HuuNgan/AC_Power_Monitoring_System/Hardware/AC Measure Monitor Control Board/v1.pdf

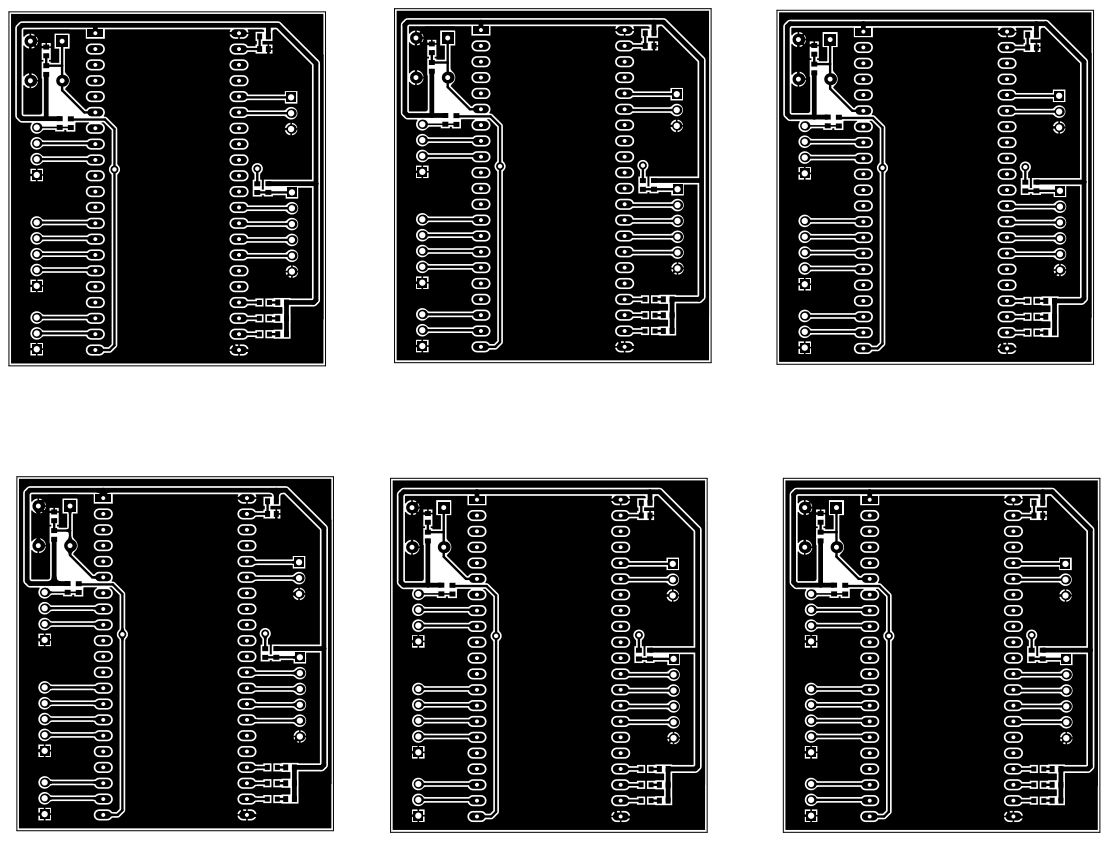
[picture p4: page 1]
