HuuNgan/AC_Power_Monitoring_System/Hardware/Isolation Boost Converter/Isolation_boost.pdf

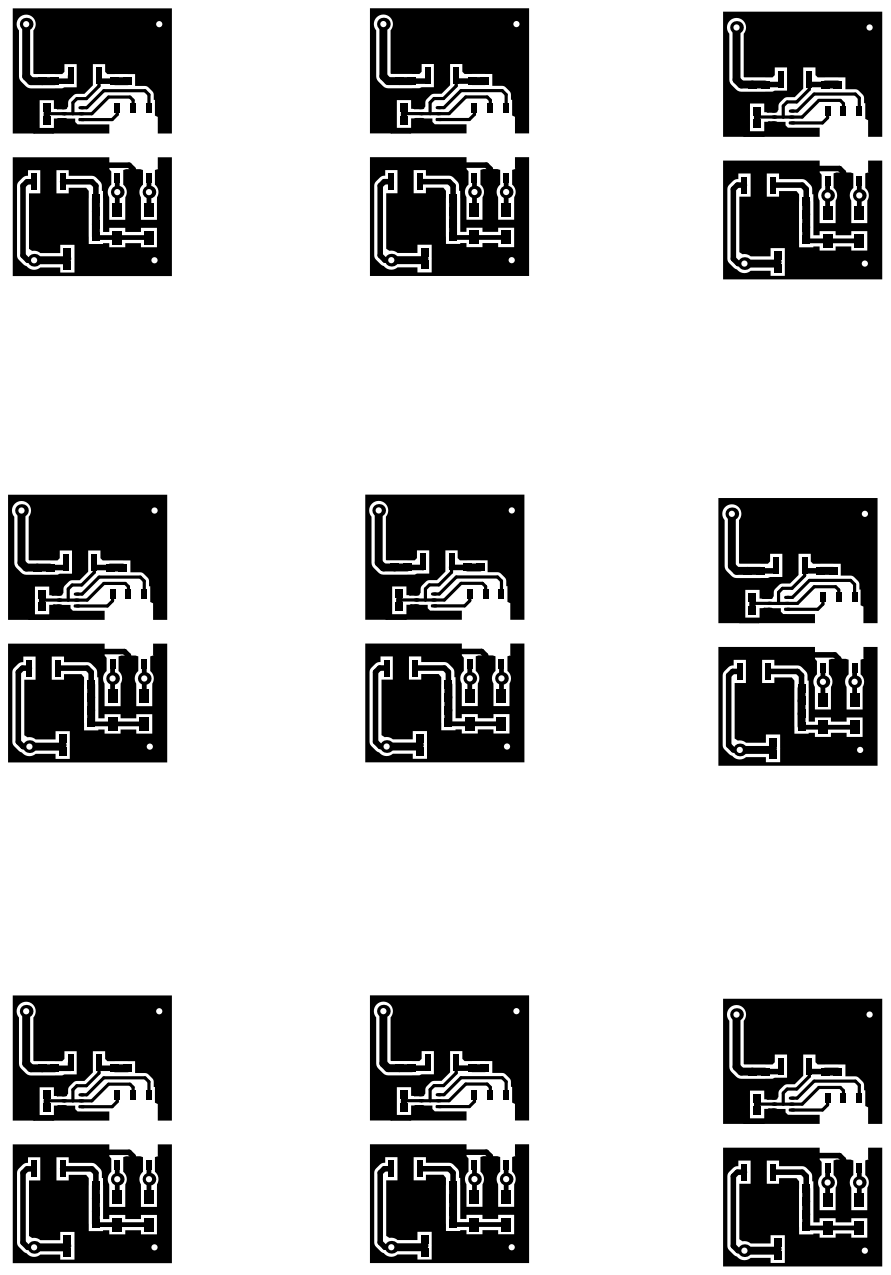
[picture p5: page 1]
