HuuNgan/AC_Power_Monitoring_System/Hardware/AC Measure Monitor Senso Board/Release/2021-03-21/Schematic.pdf

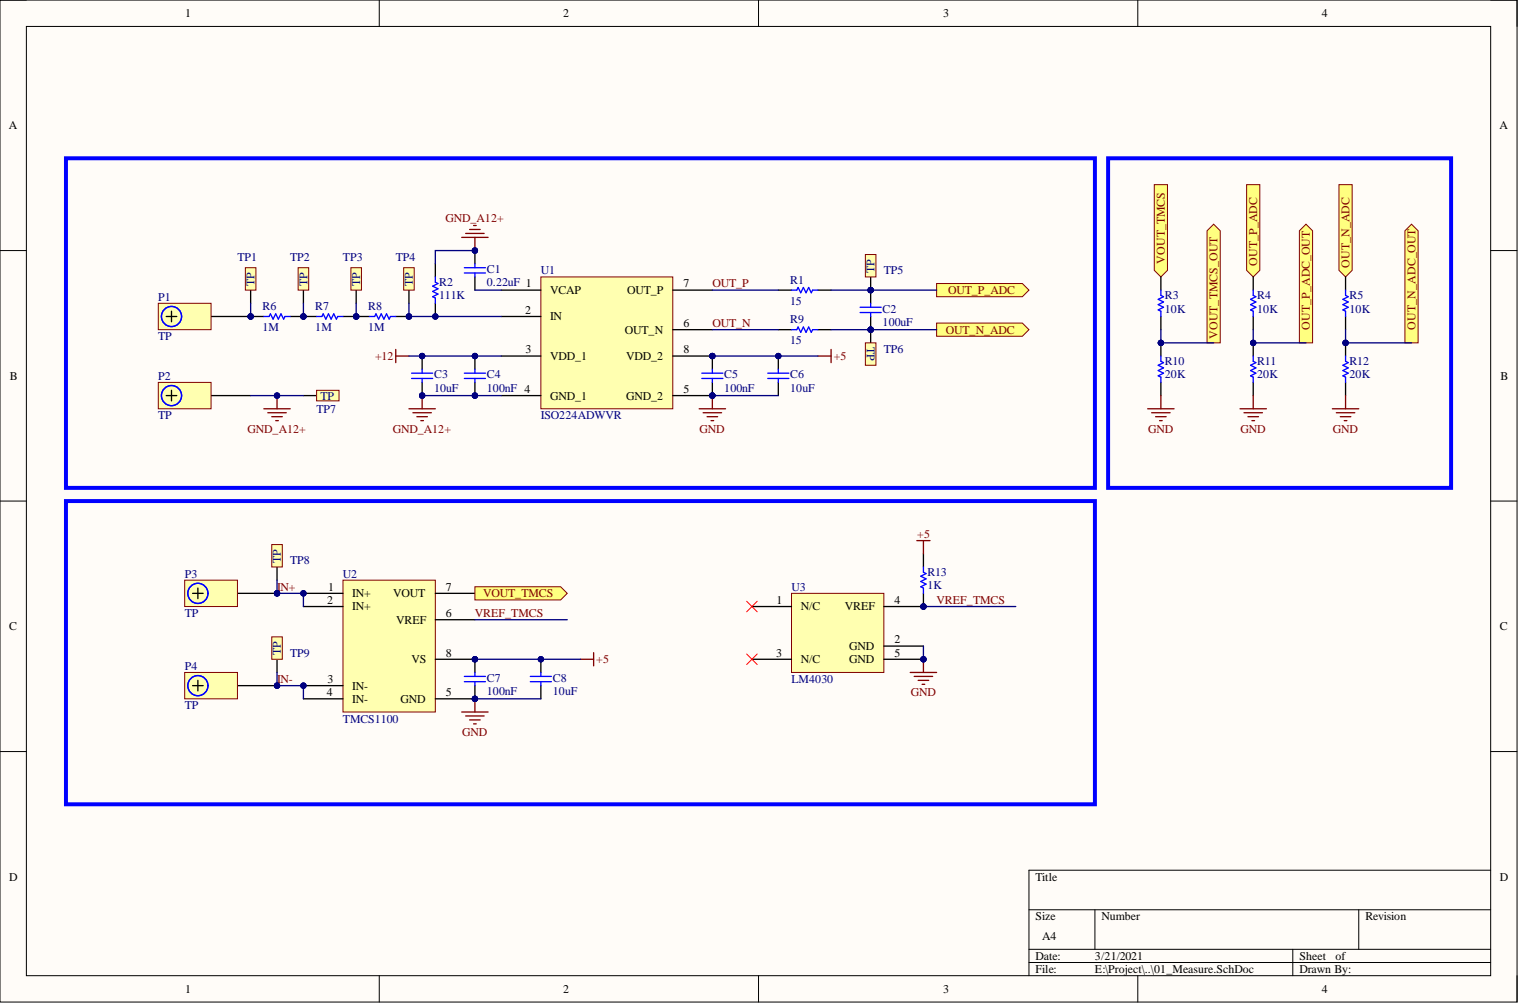
[picture p6: page 1]

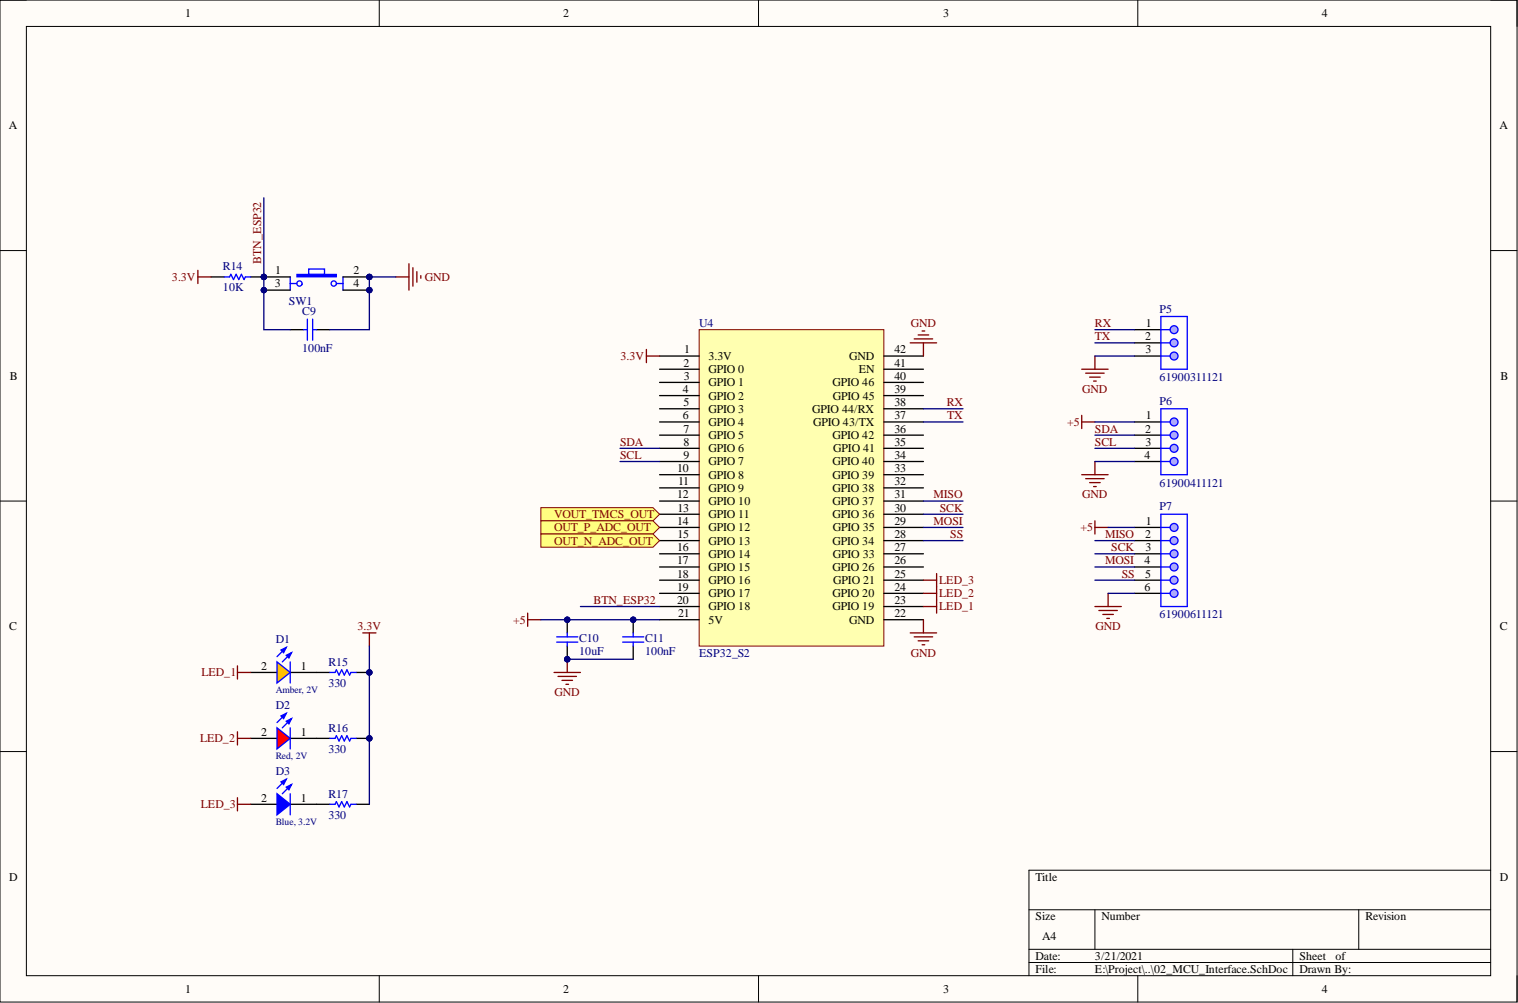
[picture p7: page 2]

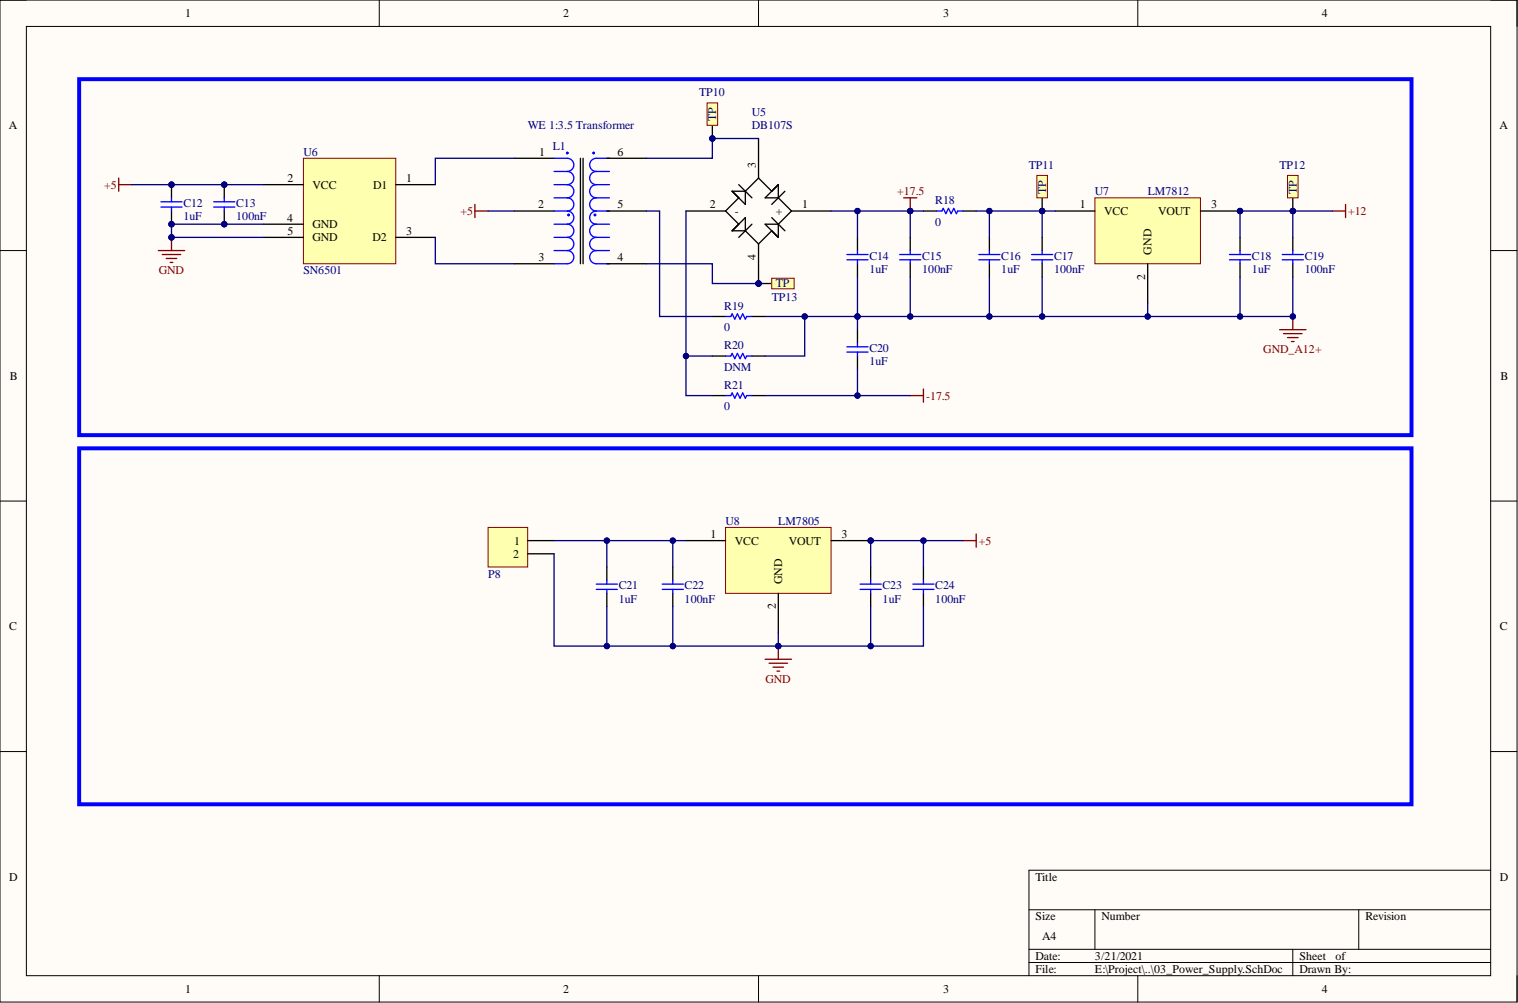
[picture p8: page 3]
