HuuNgan/AC_Power_Monitoring_System/Hardware/AC Measure Monitor Senso Board/Release/2021-03-22/Schematic.pdf

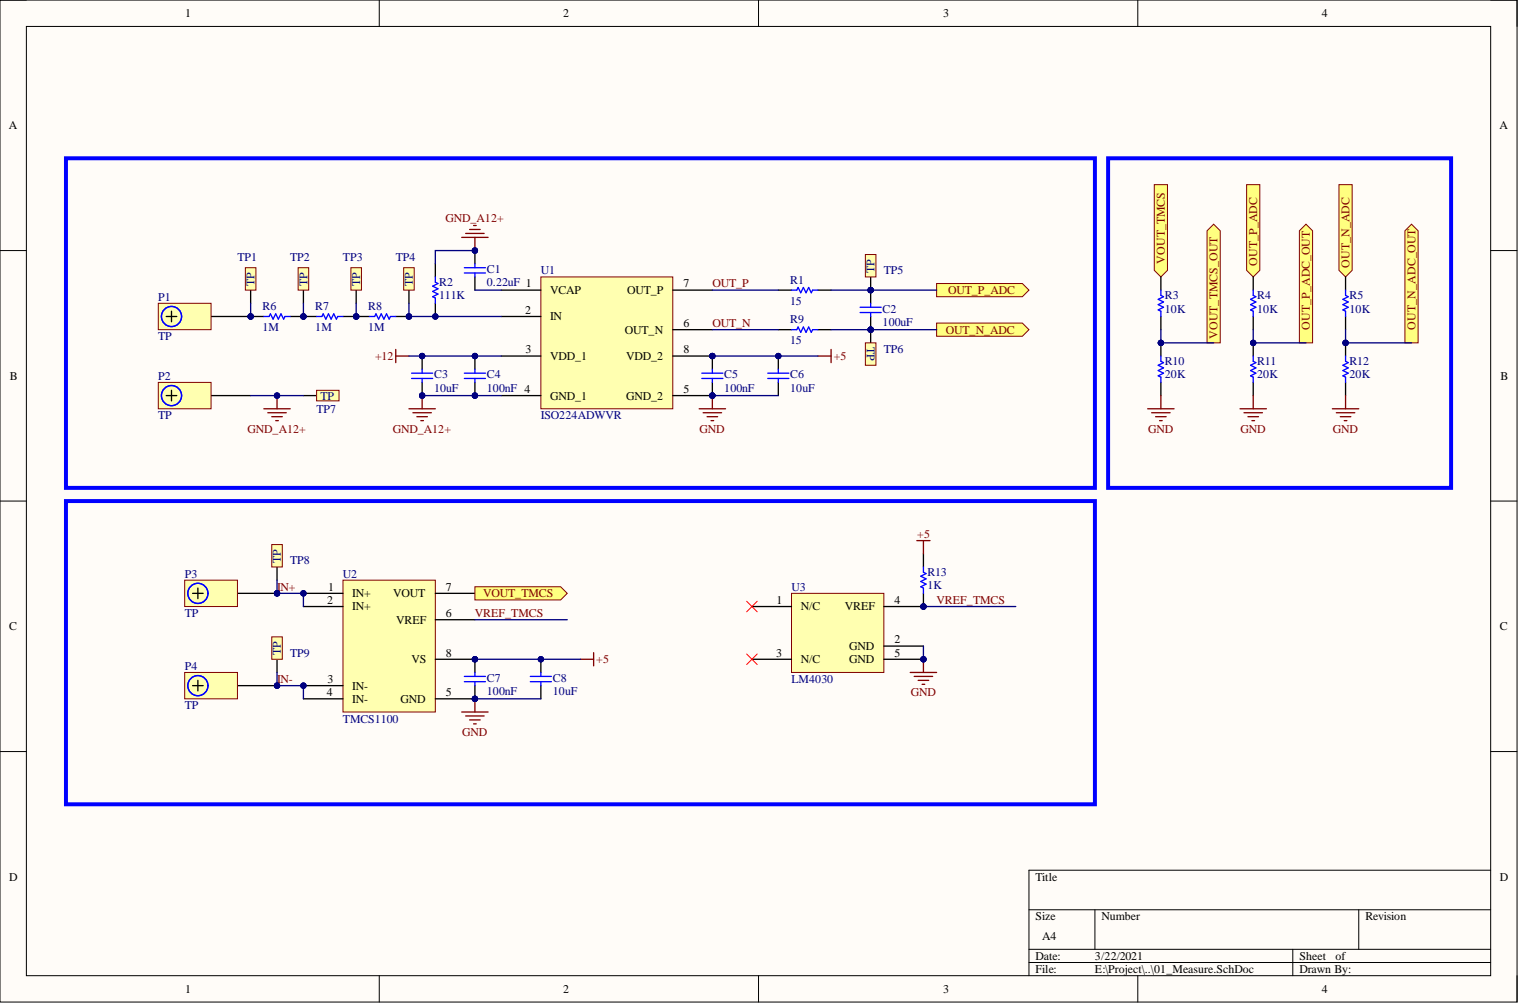
[picture p9: page 1]

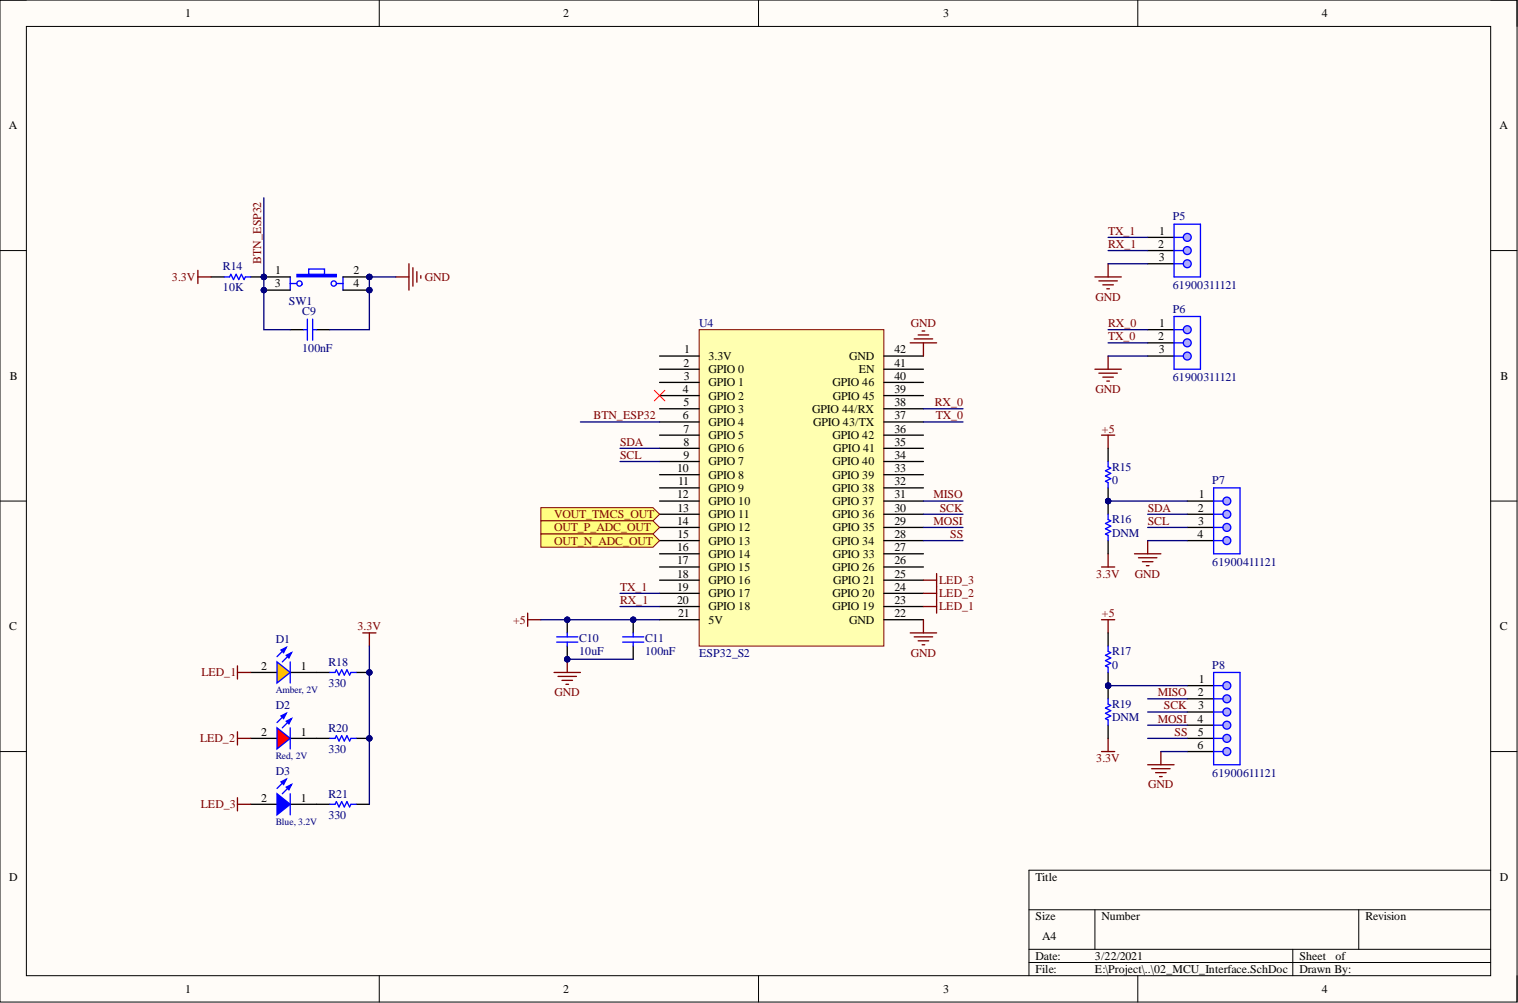
[picture p10: page 2]

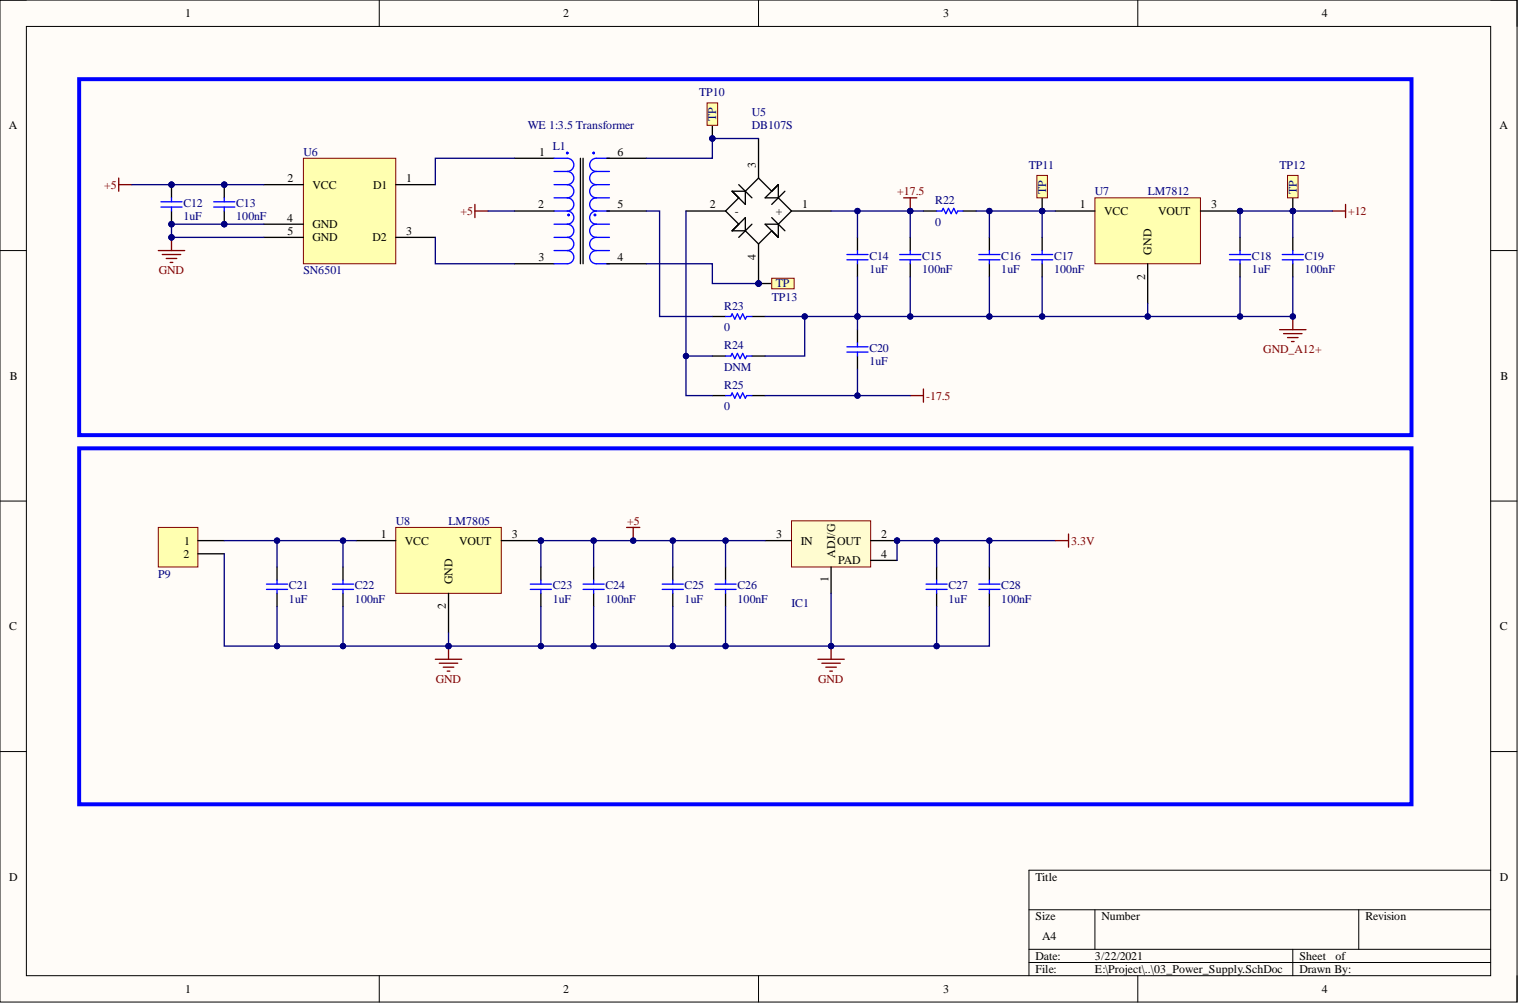
[picture p11: page 3]
