HuuNgan/AC_Power_Monitoring_System/Hardware/AC Measure Monitor Senso Board/Release/2021-04-01/Schematic.pdf

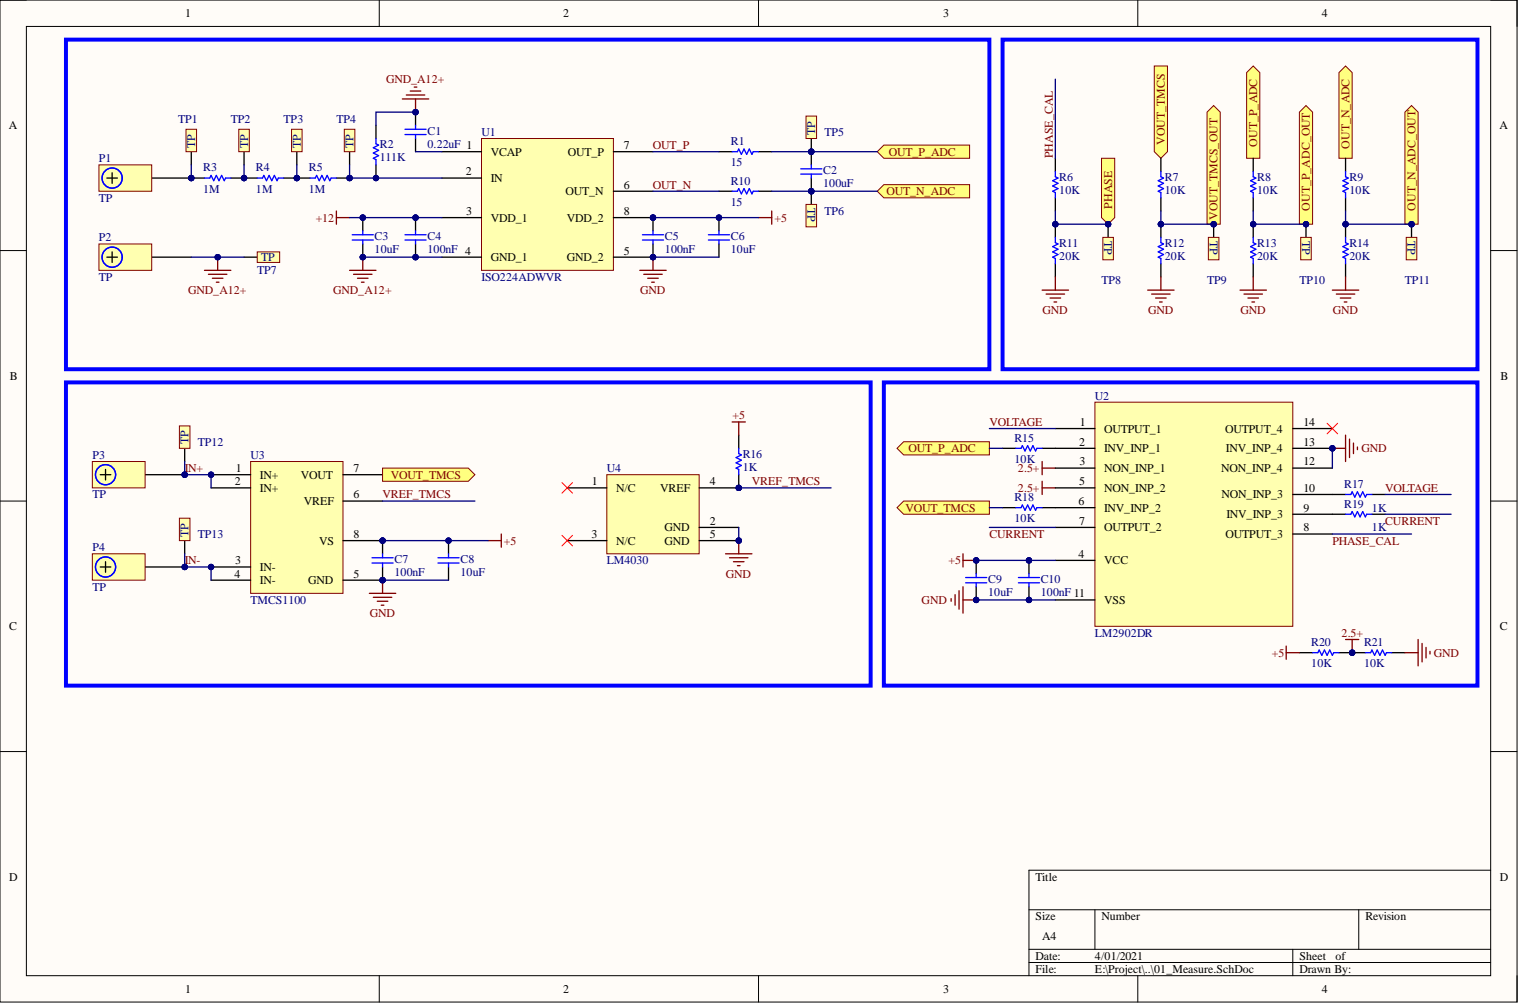
[picture p12: page 1]

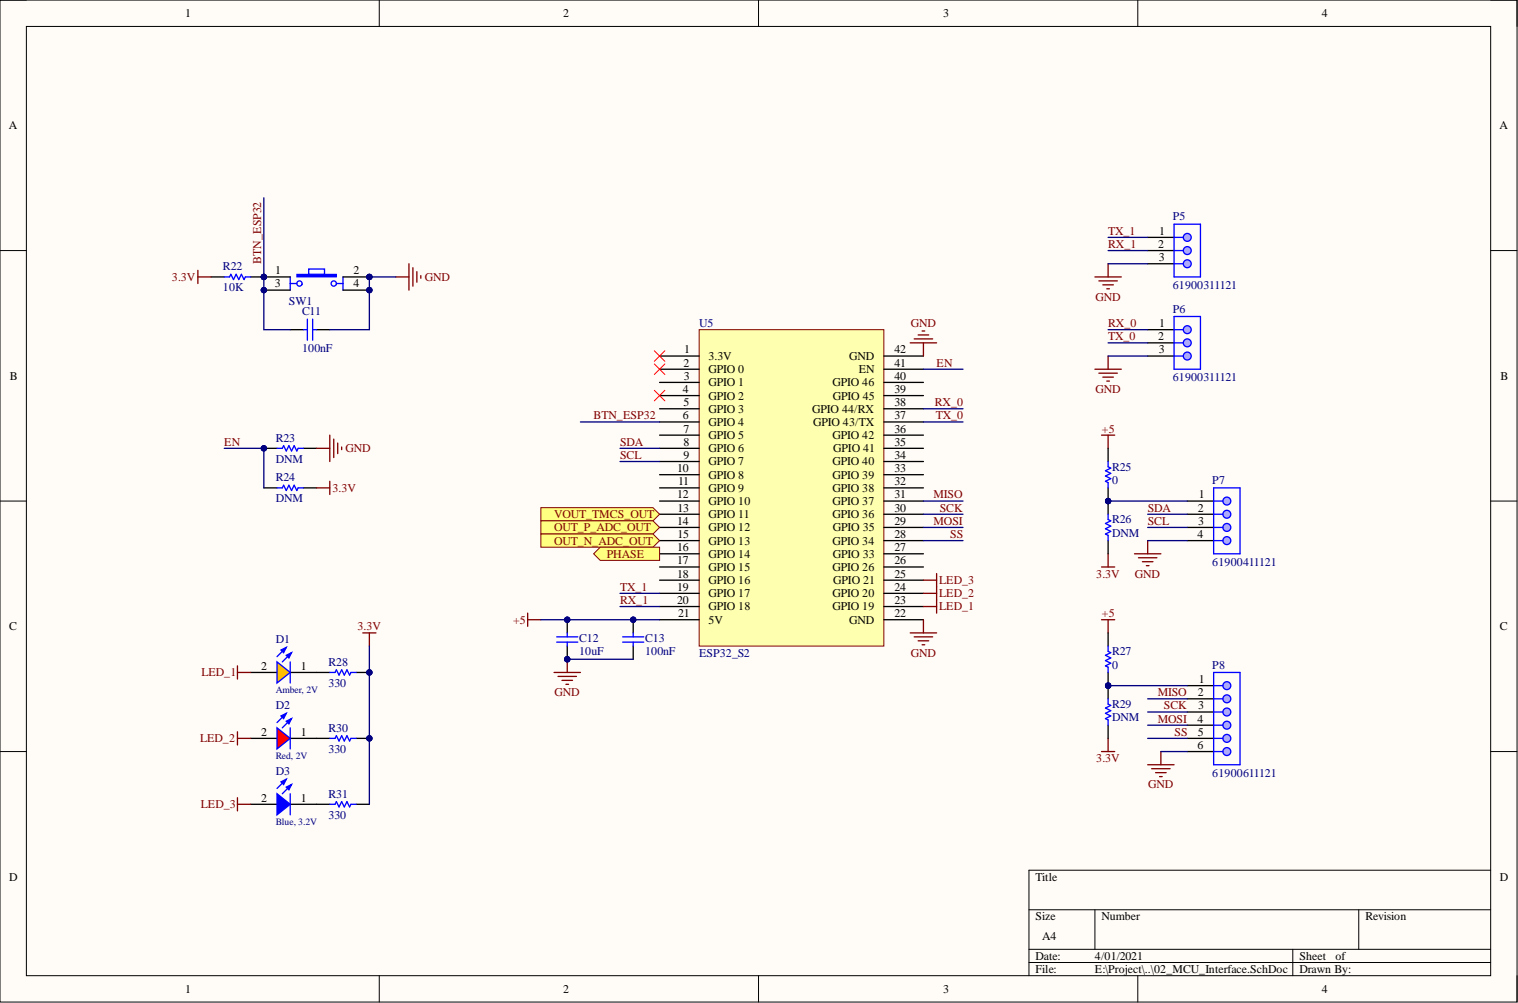
[picture p13: page 2]

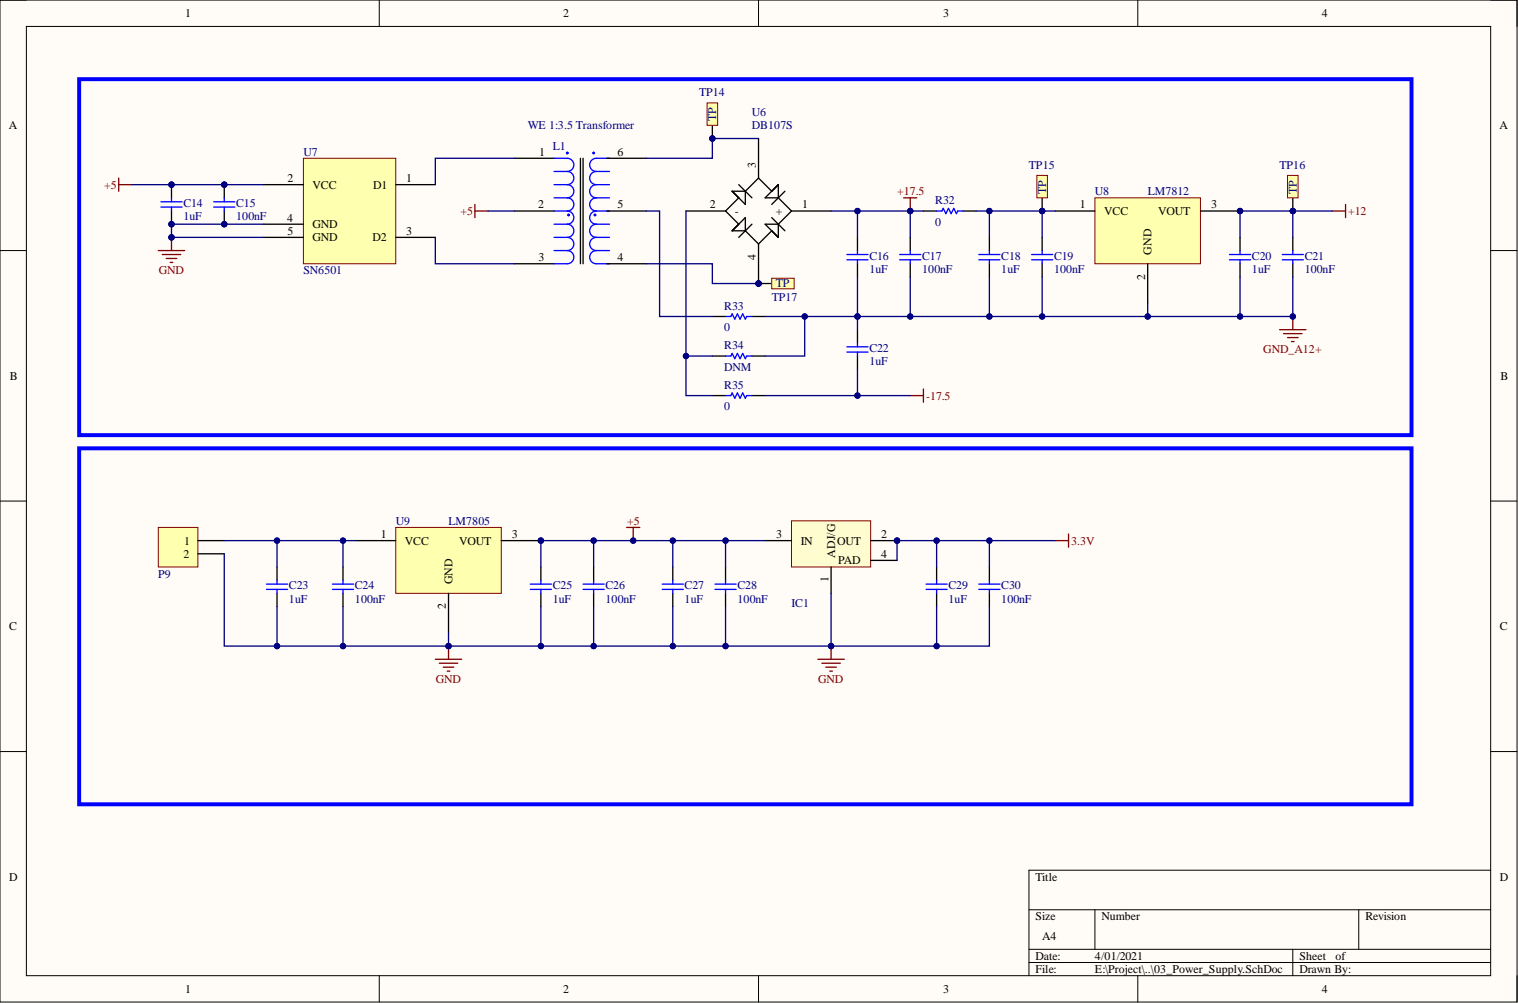
[picture p14: page 3]
