HuuNgan/AC_Power_Monitoring_System/Simulation/Phase detector.asc

R1: res; 100K
R2: res; 100K
R3: res; 1k
R4: res; 100k
R5: res; 100k
R6: res; 1k
R7: res; 10K
R15: res; 10K
U1: opamp2; LMV604
U2: opamp2; LMV604
U5: opamp2; LMV604
V4: signal; SINE(2.5 0.5 50 0 0)
V5: signal; SINE(2.5 0.5 50 0.0025)
V6: voltage; 5; Rser=0
Named nets: +5V, 0, V1, Vref, V2, Vdiff, Pulse1, Pulse2
.include D:\\LTSpice\\models\\LMV604.TXT
.tran 0.2
