HuuNgan/AC_Power_Monitoring_System/(list of files, drawings)

Other design files:
Hardware/AC Measure Monitor Control Board/01_MCU_Interface.SchDoc
Hardware/AC Measure Monitor Control Board/AC Measure Monitor Control Board.PrjPcb
Hardware/AC Measure Monitor Control Board/ControlPCB.PcbDoc
Hardware/AC Measure Monitor Senso Board/01_Measure.SchDoc
Hardware/AC Measure Monitor Senso Board/02_Power_Supply.SchDoc
Hardware/AC Measure Monitor Senso Board/AC Measure Monitor Senso Board.PrjPcb
Hardware/AC Measure Monitor Senso Board/MeasurePCB.PcbDoc
Hardware/AC Measure Monitor Senso Board/MeasurePCB.PcbLib
Hardware/AC Measure Monitor Senso Board/MeasurePCB_Clone.PcbDoc
Hardware/Isolation Boost Converter/Boost_PWR_Supply.PcbDoc
Hardware/Isolation Boost Converter/Boost_PWR_Supply.SchDoc
Hardware/Isolation Boost Converter/IsolationBoostConverter.PrjPCB
Hardware/Isolation Boost Converter/IsolationBoostConverter.SCHLIB
Hardware/Isolation Boost Converter/MeasurePCB.PcbLib
