HuuNgan/AC_Power_Monitoring_System/Firmware/ESP32S2/template-app/components/GPIO/GPIO.c

#include <stdio.h>
#include "GPIO.h"
#include "../../../main/Init.h"

static xQueueHandle gpio_evt_queue = NULL;

void IRAM_ATTR GPIO_ISR_Handler(void* arg)
{
    //do thing
    uint32_t gpio_num = (uint32_t) arg;
    xQueueSendFromISR(gpio_evt_queue, &gpio_num, NULL);
}

void vTaskGPIO_ISR_Process(void* arg)
{
    uint32_t io_num;
    for(;;)
    {
        if(xQueueReceive(gpio_evt_queue, &io_num, portMAX_DELAY)) 
        {
            uint8_t gpio_level=gpio_get_level(io_num);

            if(io_num==PHASE)
            {
                Timer_phase_cal(gpio_level);
            }
            else if(io_num==BUTTON)
            {
                Timer_Smartconfig(gpio_level);
            }

            #if DEBUG_USER_GPIO
            printf("GPIO[%d] intr, val: %d\n", io_num, gpio_level);
            #endif
        }
    }
}

void GPIO_init(void)
{
    gpio_config_t gpio_init_cfg;

    //config built in LED
    gpio_init_cfg.pin_bit_mask=BLINK_LED_PIN_SEL;
    gpio_init_cfg.mode=GPIO_MODE_OUTPUT;
    gpio_init_cfg.intr_type=GPIO_INTR_DISABLE;
    gpio_init_cfg.pull_down_en=0;
    gpio_init_cfg.pull_up_en=0;
    gpio_config(&gpio_init_cfg);

    //config phase detect
    gpio_init_cfg.pin_bit_mask=PHASE_PIN_SEL;
    gpio_init_cfg.mode=GPIO_MODE_INPUT;
    gpio_init_cfg.intr_type=GPIO_INTR_ANYEDGE;
    gpio_init_cfg.pull_down_en=1;
    gpio_init_cfg.pull_up_en=0;
    gpio_config(&gpio_init_cfg);

    //config button to smartconfig
    gpio_init_cfg.pin_bit_mask=BUTTON_PIN_SEL;
    gpio_init_cfg.mode=GPIO_MODE_INPUT;
    gpio_init_cfg.intr_type=GPIO_INTR_ANYEDGE;
    gpio_init_cfg.pull_down_en=1;
    gpio_init_cfg.pull_up_en=0;
    gpio_config(&gpio_init_cfg);

    gpio_install_isr_service(ESP_INTR_FLAG_DEFAULT);
    gpio_evt_queue = xQueueCreate(10, sizeof(uint32_t));
    gpio_isr_handler_add(PHASE, GPIO_ISR_Handler, (void*) PHASE);
    gpio_isr_handler_add(BUTTON, GPIO_ISR_Handler, (void*) BUTTON);
}

void control_other_pin(uint16_t pin, bool control)
{
    //do thing
}

void control_built_in_led(bool control)
{
    gpio_set_level(BLINK_LED,control);
}
