HuuNgan/AC_Power_Monitoring_System/Firmware/ESP32S2/template-app/main/Init.h

#ifndef INIT_H
#define INIT_H

#define DEBUG_USER_MQTT                 0
#define DEBUG_USER_ADC                  0
#define DEBUG_USER_GPIO                 0
#define DEBUG_USER_TIMER                0
#define DEBUG_USER_TIMER_PHASE          0
#define DEBUG_USER_TIMER_SMART_CONFIG   0

#define Time_dilation 1

/*Config pinout*/

#define ADC_CHANNEL_VOLTAGE_P_PIN   13
#define ADC_CHANNEL_VOLTAGE_N_PIN   14
#define ADC_CHANNEL_CURRENT_PIN     11
#define BLINK_LED_PIN               2
#define PHASE_PIN                   4
#define BUTTON_INPUT_PIN            5

#endif
