HuuNgan/AC_Power_Monitoring_System/(commit log)

2021-03-15 add folder altium
    [AC_PWRM_Control.PcbDoc, AC_PWRM_Control.PrjPCB, AC_PWRM_Control.SchDoc]
2021-03-22 [Micls] Add Schematic
    [01_Measure.SchDoc, 02_MCU_Interface.SchDoc, 03_Power_Supply.SchDoc, AC Measure Monitor Senso Board.PrjPcb, MeasurePCB.PcbDoc]
2021-03-22 [Micls] Delete folder in main branch
    [AC_PWRM_Control.PcbDoc, AC_PWRM_Control.PrjPCB, AC_PWRM_Control.SchDoc]
2021-04-13 [Micls] Update schematic
    [01_MCU_Interface.SchDoc, 01_Measure.SchDoc, 02_MCU_Interface.SchDoc, 02_Power_Supply.SchDoc, 03_Power_Supply.SchDoc, AC Measure Monitor Control Board.PrjPcb, ControlPCB.PcbDoc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]
2021-04-18 Add ADC and MQTT and publish
2021-04-19 Add timer_init and change MQTT and ADC
2021-04-20 add esp32_datasheet
2021-04-29 Add MQTT Sub and change ADC Calib
2021-05-25 Add power comsumtion cal and public to mqtt server
2021-05-28 add Isolation Boost Converter in Hardware
    [Boost_PWR_Supply.PcbDoc, Boost_PWR_Supply.SchDoc, IsolationBoostConverter.PrjPCB, IsolationBoostConverter.SCHLIB, MeasurePCB.PcbLib]
